valentinp72/star-track/cad/slew.gif

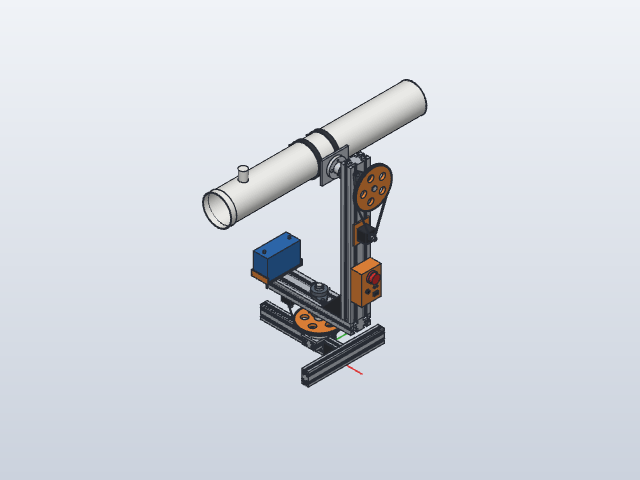
cad/slew.gif
