valentinp72/star-track/cad/electronics-box.stl

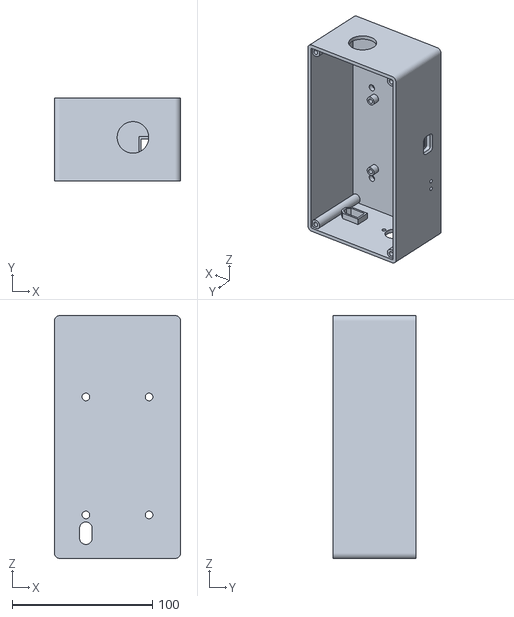
[picture p5: CAD file, 2026-11-12]
cad/electronics-box.stl
90.0 x 59.0 x 173.0
