valentinp72/star-track/cad/electronics-box-lid.stl

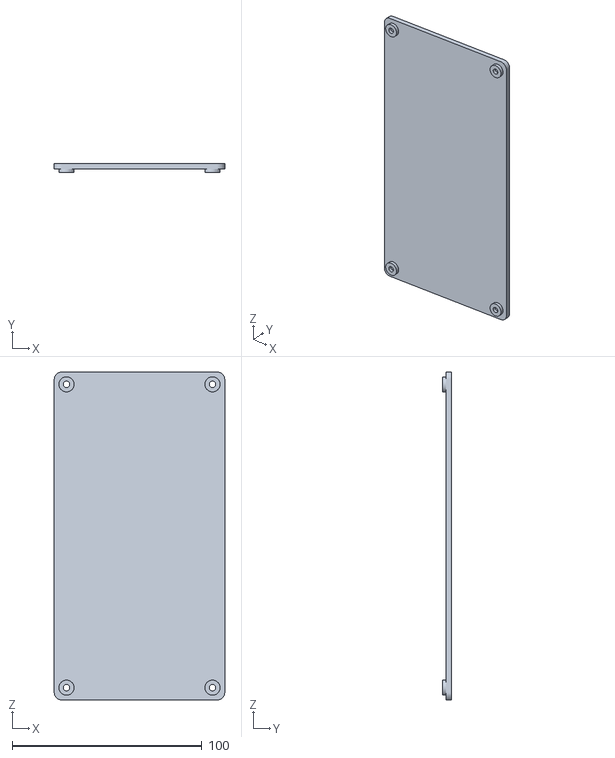
[picture p6: CAD file, 2026-11-12]
cad/electronics-box-lid.stl
90.0 x 5.00 x 173.0
