valentinp72/star-track/cad/knob-m5.stl

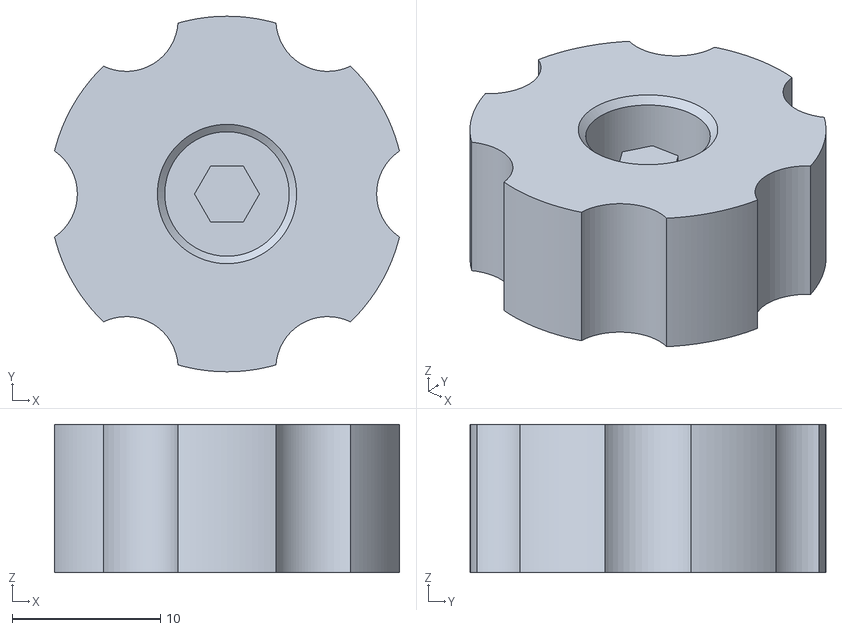
[picture p7: CAD file, 2026-11-04]
cad/knob-m5.stl
23.3 x 24.0 x 10.0
