valentinp72/star-track/cad/azimuth-motor-spacer.stl

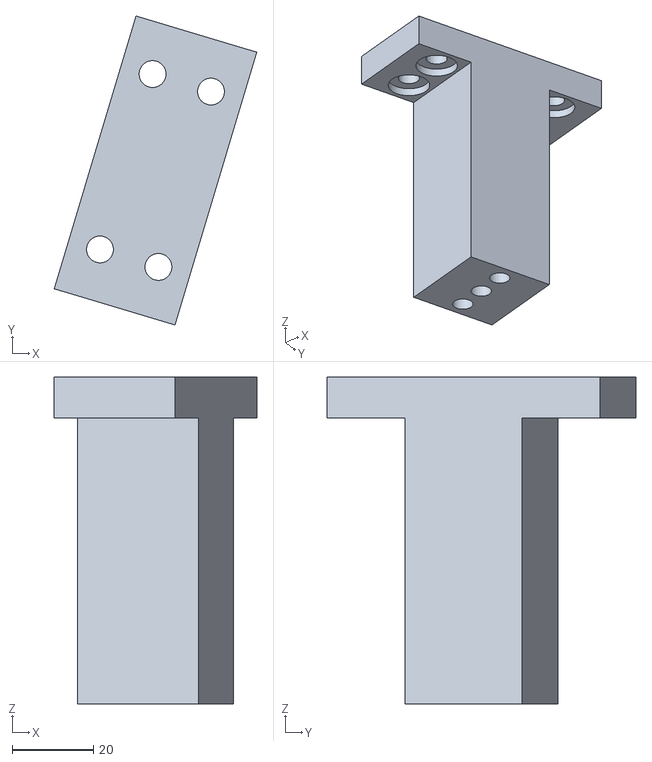
[picture p8: CAD file, 2026-11-04]
cad/azimuth-motor-spacer.stl
49.8 x 76.0 x 80.3
