valentinp72/star-track/cad/altitude-motor-spacer.stl

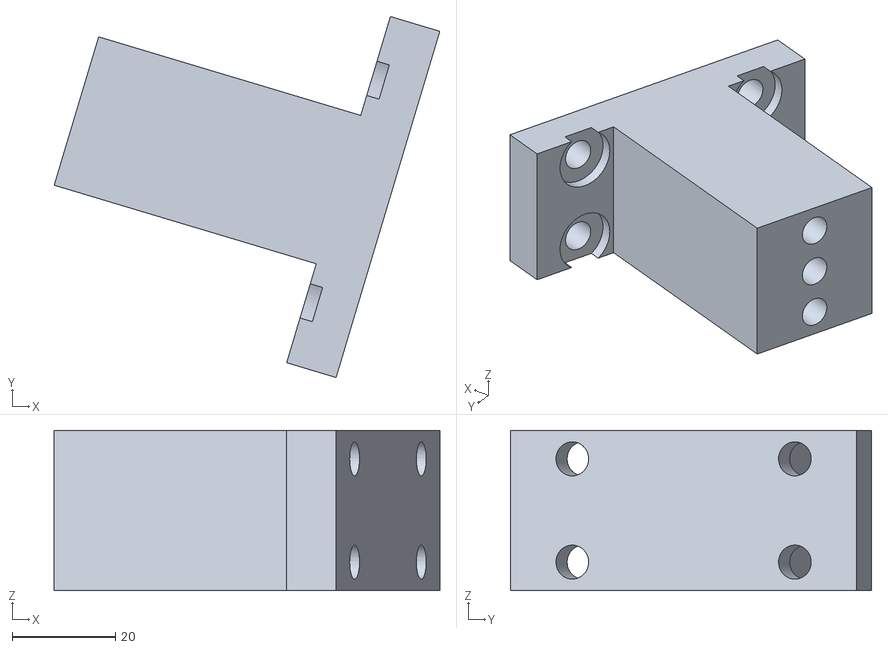
[picture p9: CAD file, 2026-11-04]
cad/altitude-motor-spacer.stl
74.7 x 69.9 x 31.0
