valentinp72/star-track/cad/pulley-gt2-250t.stl

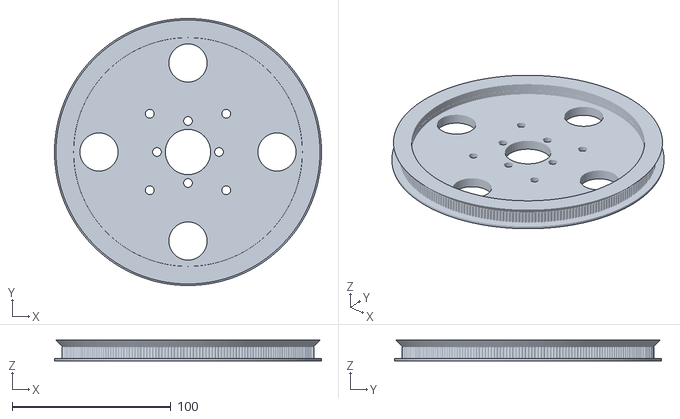
[picture p10: CAD file, 2026-10-29]
cad/pulley-gt2-250t.stl
168.0 x 168.0 x 13.0
