valentinp72/star-track/cad/azimuth-pulley-ring.stl

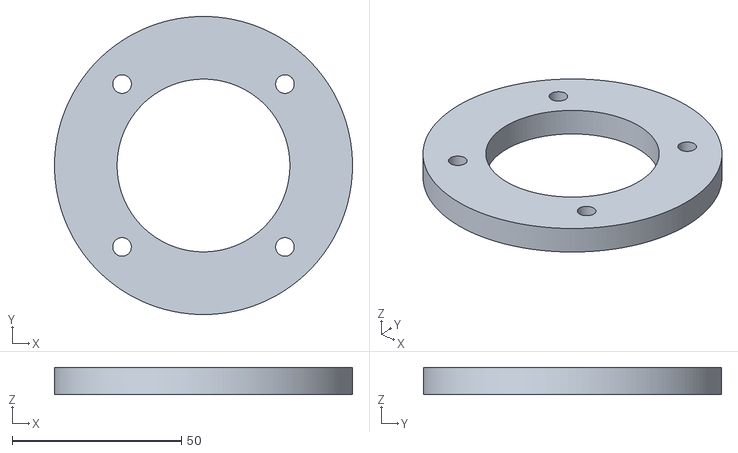
[picture p11: CAD file, 2026-10-29]
cad/azimuth-pulley-ring.stl
88.0 x 88.0 x 8.00
