valentinp72/star-track/electronics/star-track.pdf

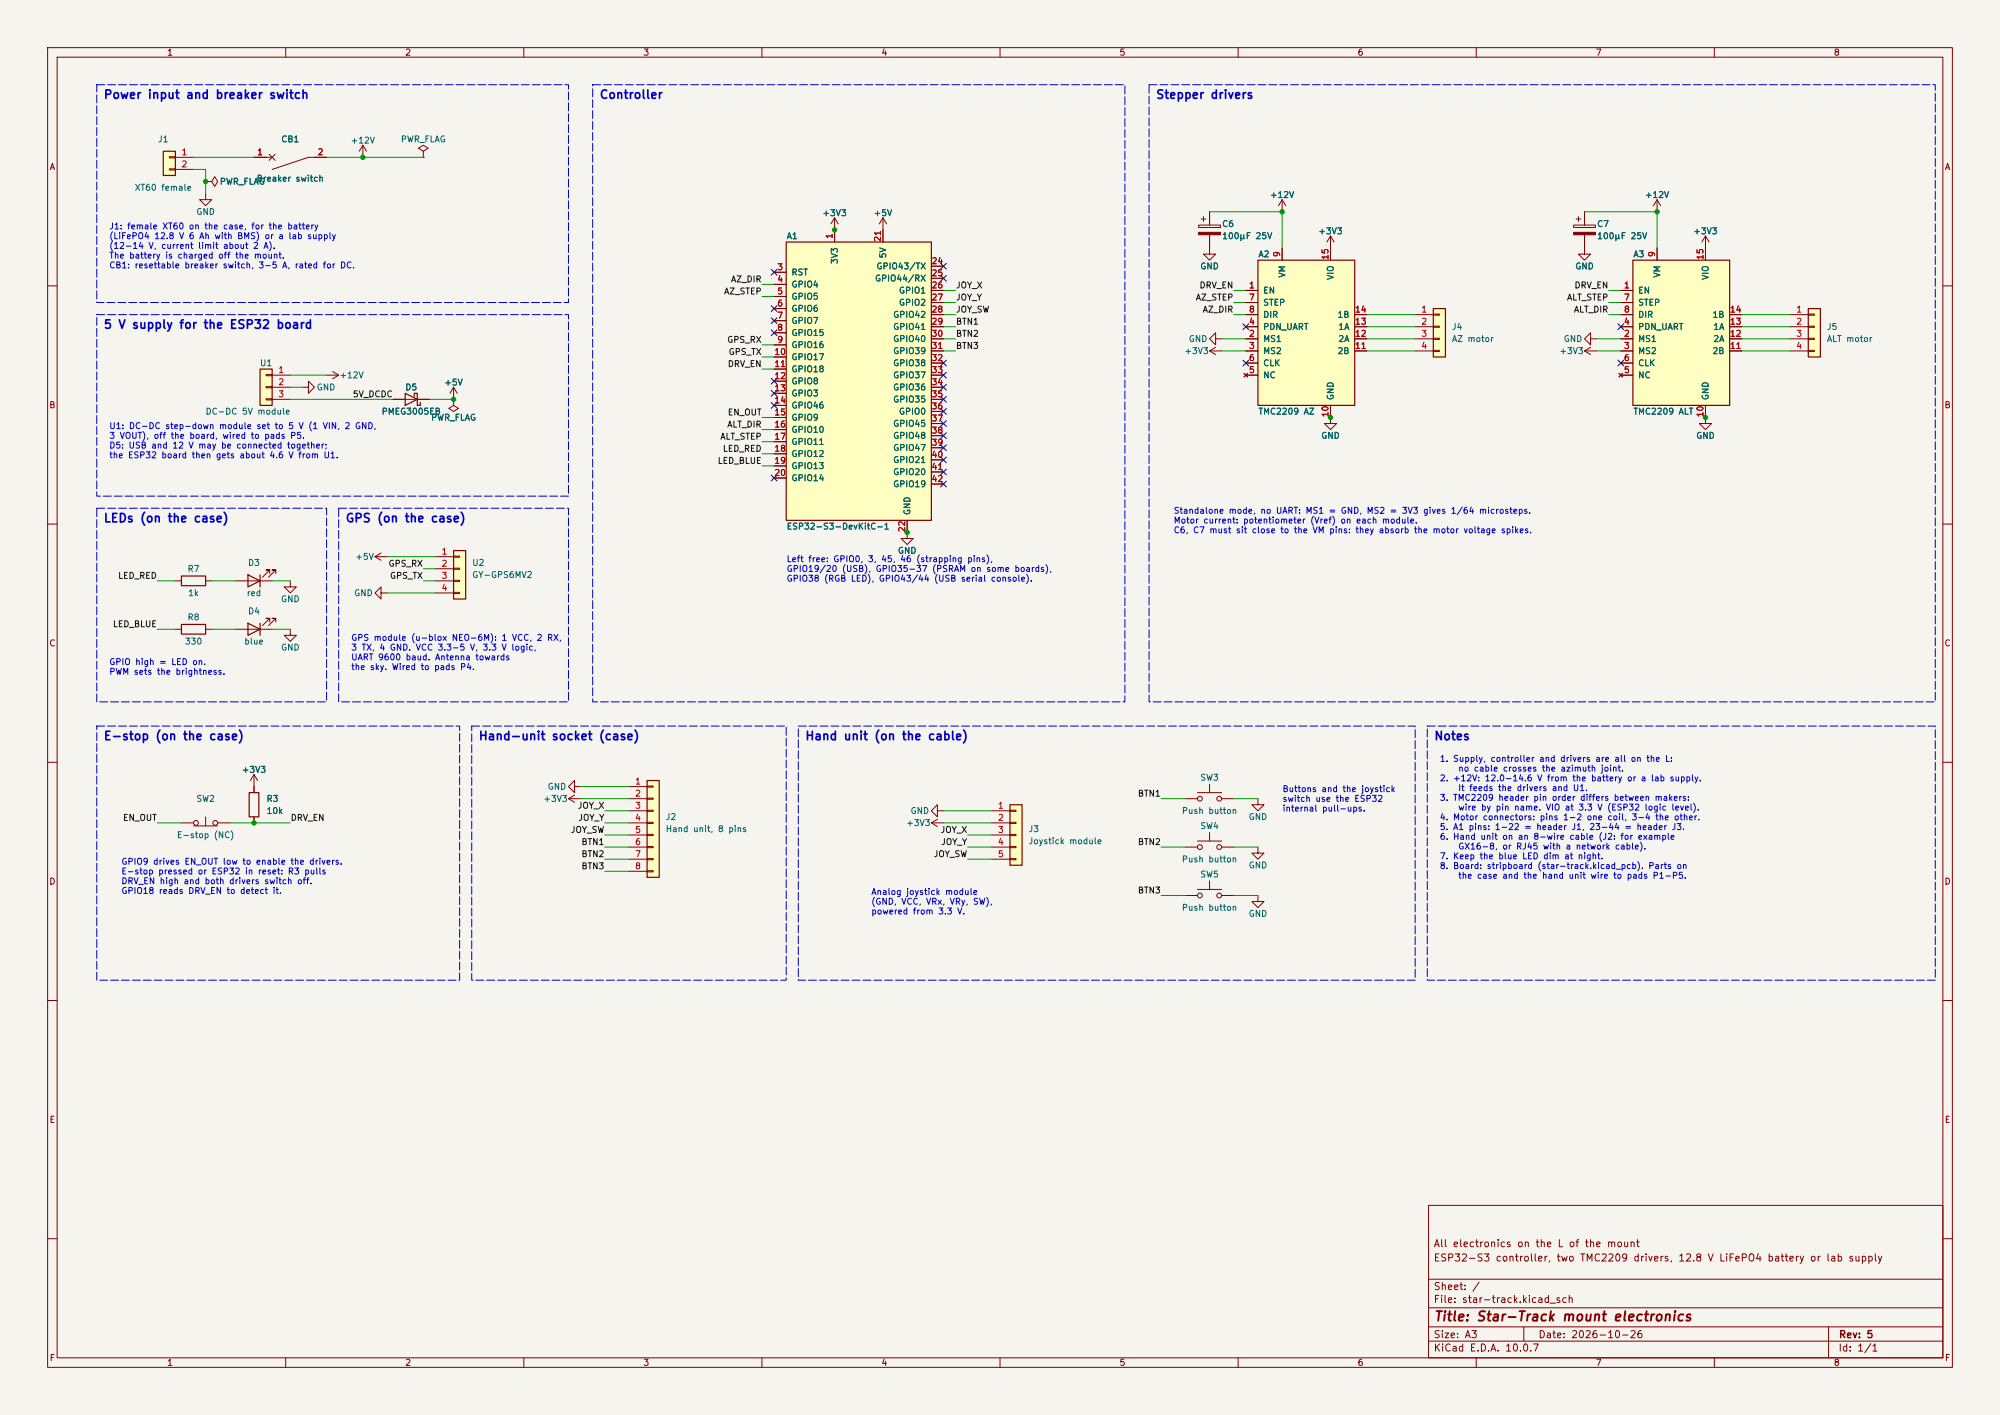
[picture p12: page 1]

Power input and breaker switch

J1: female XT60 on the case, for the battery
(LiFePO4 12.8 V 6 Ah with BMS) or a lab supply

5 V supply for the ESP32 board

powered from 3.3 V. LEDs (on the case) GPIO high = LED on. PWM sets the brightness.
EN_OUT LED_RED

the case and the hand unit wire to pads P1-P5. Standalone mode, no UART: MS1 = GND, MS2 = 3V3 gives 1/64 microsteps. Motor current: potentiometer (Vref) on each module. C6, C7 must sit close to the VM pins: they absorb the motor voltage spikes.

internal pull-ups. Left free: GPIO0, 3, 45, 46 (strapping pins),
GPIO19/20 (USB), GPIO35-37 (PSRAM on some boards), GPIO38 (RGB LED), GPIO43/44 (USB serial console).

Hand unit (on the cable)

It feeds the drivers and U1. 3. TMC2209 header pin order differs between makers: wire by pin name. VIO at 3.3 V (ESP32 logic level). 4. Motor connectors: pins 1-2 one coil, 3-4 the other. 5. A1 pins: 1-22 = header J1, 23-44 = header J3. 6. Hand unit on an 8-wire cable (J2: for example

GX16-8, or RJ45 with a network cable). 7. Keep the blue LED dim at night. 8. Board: stripboard (star-track.kicad_pcb). Parts on

Analog joystick module
(GND, VCC, VRx, VRy, SW),

All electronics on the L of the mount GND

ESP32-S3 controller, two TMC2209 drivers, 12.8 V LiFePO4 battery or lab supply

Sheet: /
File: star-track.kicad_sch
Title: Star-Track mount electronics

Size: A3 | Rev: 5 | F Date: 2026-10-26
KiCad E.D.A. 10.0.7 | Id: 1/1
