valentinp72/star-track/electronics/star-track.kicad_pcb

## KiCad design electronics/star-track.kicad_pcb (2026-11-09)

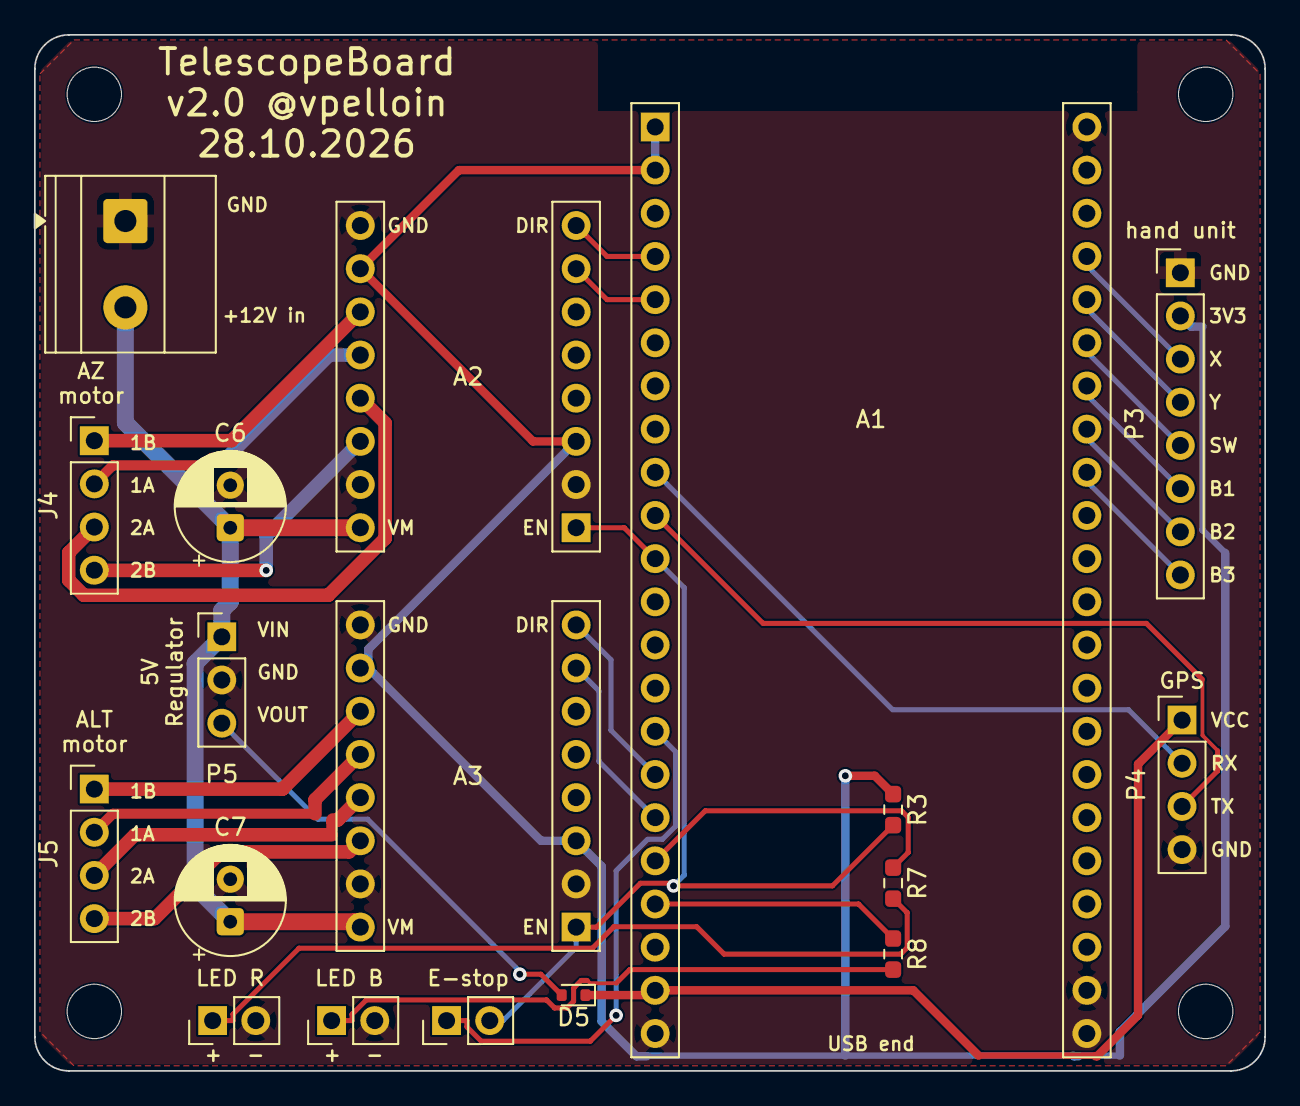
[picture p13: board star-track.kicad_pcb from above]

Board: 2 copper layers, 72.4 x 61.0 mm, 22 parts (0 on the bottom side), 31 nets.

Parts:
A1: ESP32-S3-DevKitC-1; ESP32-S3-DevKitC-1_Socket
A2: TMC2209 AZ; TMC2209_StepStick_Socket
A3: TMC2209 ALT; TMC2209_StepStick_Socket
C6, C7: 100µF 25V; CP_Radial_D6.3mm_P2.50mm
D5: PMEG3005EB; D_SOD-523
H1, H2, H3, H4: MountingHole_3.2mm_M3
J4: AZ motor; PinHeader_1x04_P2.54mm_Vertical
J5: ALT motor; PinHeader_1x04_P2.54mm_Vertical
P1: EK508V-02P; TerminalBlock_Phoenix_MKDS-1,5-2-5.08_1x02_P5.08mm_Horizont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
P2: Red LED (D3); PinHeader_1x02_P2.54mm_Vertical
P3: Hand unit (J2); PinHeader_1x08_P2.54mm_Vertical
P4: GPS (U2); PinHeader_1x04_P2.54mm_Vertical
P5: DC-DC 5V (U1); PinHeader_1x03_P2.54mm_Vertical
P6: Blue LED (D4); PinHeader_1x02_P2.54mm_Vertical
P7: E-stop (SW2); PinHeader_1x02_P2.54mm_Vertical
R3: 220; R_0603_1608Metric_Pad0.98x0.95mm_HandSolder
R7: 1k; R_0603_1608Metric_Pad0.98x0.95mm_HandSolder
R8: 330; R_0603_1608Metric_Pad0.98x0.95mm_HandSolder

Connections:
+3V3: A1.1, A1.2, A2.3, A2.15, A3.3, A3.15, P3.2, R3.1
+5V: A1.21, D5.1, P4.1
+12V: A2.9, A3.9, C6.1, C7.1, P1.2, P5.1
/5V_DCDC: D5.2, P5.3
/ALT_DIR: A1.16, A3.8
/ALT_STEP: A1.17, A3.7
/AZ_DIR: A1.4, A2.8
/AZ_STEP: A1.5, A2.7
/BTN1: A1.29, P3.6
/BTN2: A1.30, P3.7
/BTN3: A1.31, P3.8
/DRV_EN: A1.11, A2.1, A3.1, P7.2, R3.2
/EN_OUT: A1.15, P7.1
/GPS_RX: A1.9, P4.2
/GPS_TX: A1.10, P4.3
/JOY_SW: A1.28, P3.5
/JOY_X: A1.26, P3.3
/JOY_Y: A1.27, P3.4
/LED_BLUE: A1.19, R8.1
/LED_RED: A1.18, R7.1
GND: A1.22, A1.23, A1.43, A1.44, A2.2, A2.10, A2.16, A3.2, A3.10, A3.16, C6.2, C7.2, P1.1, P2.2, P3.1, P4.4, P5.2, P6.2
unnamed: A2.13, J4.2
unnamed: A2.14, J4.1
unnamed: A2.12, J4.3
unnamed: A2.11, J4.4
unnamed: A3.13, J5.2
unnamed: A3.14, J5.1
unnamed: A3.12, J5.3
unnamed: A3.11, J5.4
unnamed: P2.1, R7.2
unnamed: P6.1, R8.2
