valentinp72/star-track/(commit log)

2025-12-17 wifi AP esp32
2026-10-25 Restart project with design notes and a 3D model of the mount
    The previous main (ESP-IDF Wi-Fi access point example) is kept as branch v3.
    - README.md: project summary and the earlier branches.
    - docs/architecture.md: planned ESP32-S3 controller, phone web app,
    firmware structure, emergency stop wiring.
    - docs/mechanics.md: current build dimensions from the CAD export,
    bearing redesign with flange bearings, base stability, transport.
    - docs/3d/index.html: interactive 3D model of the redesigned mount.
    Claude-Session: https://claude.ai/code/session_019gYbrjmddARBSj5u2J2ySh
2026-10-25 Add battery power design and electronics schematic
    - electronics/: KiCad 7 schematic (with PDF and PNG exports) of the
    12.8 V LiFePO4 power path, L7805 5 V supply, battery voltage divider,
    ESP32-S3-DevKitC-1, two TMC2209 drivers on a shared UART, E-stop,
    joystick and buttons. Project symbol library for the board and the
    driver module.
    - docs/architecture.md: power, pin assignment, driver wiring, runtime
    estimate and placement on the L; azimuth needs no cable-wrap limit.
    - docs/mechanics.md: battery at the far end of the bar, smaller
    electronics case without screen, updated transport size.
    - docs/3d: battery in a printed cradle, battery cable, new case with
    E-stop, joystick and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
2026-10-25 Drop charging circuit; add hand unit, LEDs and buzzer
    - Schematic: female XT60 input for the battery or a lab supply, no
    charge socket. Joystick and buttons moved to a hand unit on an 8-pin
    socket, with 100 nF filters on the joystick lines. Red and blue LEDs
    (GPIO15, GPIO16) and a buzzer driven by an NPN transistor (GPIO21).
    - docs/architecture.md: hand unit, feedback, power input and lab supply,
    notes on charging LiFePO4 with a lead-acid charger.
    - docs/mechanics.md, docs/3d: case face with E-stop, LEDs, buzzer and
    main switch, sockets underneath; packed head size updated.
    Claude-Session: https://claude.ai/code/session_019gY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
2026-10-25 Simplify the circuit to the parts that are needed
    - Resettable breaker switch replaces the fuse and the main switch.
    - TMC2209 drivers in standalone mode (1/64 microsteps with MS1/MS2,
    current from the Vref potentiometer): no UART resistor or wires.
    - Buzzer directly on GPIO21, without the transistor stage.
    - Removed the bulk and regulator capacitors, the battery voltage
    divider and the joystick filter capacitors.
    - docs/architecture.md: why the remaining parts are needed, and a
    "Left out" table with what each removed part would add.
    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
2026-10-25 Remove the diode between the L7805 and the ESP32 board
    The L7805 output goes straight to the board's 5V pin. Espressif lists
    the board's USB ports and 5V pin as mutually exclusive power inputs,
    so the docs and schematic now say not to connect USB while the breaker
    is on, and to use Wi-Fi for logs and updates when the mount is powered.
    The diode is listed under "Left out" for USB debugging with the motors
    powered.
    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
2026-10-25 SolidCraft assembly
2026-10-25 Mount the tube with the original clasp on a plate on the altitude coupling
    Replace the Vixen dovetail with the Omegon tube clasp, fixed to a
    100 x 121 x 8 aluminium plate bolted directly to the altitude flange
    coupling. The coupling is turned 45 degrees and two of its holes are
    drilled out to 10.5 mm so the clasp bolts (60 mm apart) pass through it.
    Raise the altitude axis by 50 mm (now 70 mm below the top of the arm),
    with the altitude motor, bracket and belt, so the back of the tube
    clears the top of the azimuth shaft near the zenith. The tube can slide
    -60 / +40 mm in the clasp for balancing.
    Ignore SolidCraft lock and backup files.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
2026-10-26 Add a stripboard layout for the electronics, and a parts list
    - electronics/star-track.kicad_pcb: 24 x 56 hole stripboard. Strips are
    B.Cu tracks with 54 cuts, wire links are board-only parts with joined
    pads, so DRC checks the board against the schematic (0 violations).
    - Project footprints for the ESP32-S3-DevKitC-1 and the TMC2209 module.
    - Pictures of the component side and the copper side.
    - Schematic rev 5: GPIOs chosen to suit the stripboard, motor connector
    pins in module order, footprints assigned, case and hand-unit parts
    marked off the board.
    - docs: stripboard section, new pin table, electronics parts list.
    - Ignore KiCad local settings, locks and backups.
    Co-Authored-By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
2026-10-26 Drop the buzzer; colour the stripboard pictures by net
    - Remove BZ1 and its GPIO from the schematic, the stripboard and the
    docs. Feedback at the mount is the two LEDs. P2 keeps five pads.
    - Stripboard pictures: one colour per net for the strips and the wire
    links, fixed colours for GND, +12V, +3V3 and +5V.
2026-10-27 Replace the L7805 with a DC-DC converter, add a GPS module
    - U1 is now a DC-DC step-down module set to 5 V, off the board on three
    wires (pads P5). The L7805 and its heatsink are gone.
    - GPS module GY-GPS6MV2 (u-blox NEO-6M) on GPIO16/17, powered from 5 V,
    wired to pads P4. It gives the time and the site to the firmware.
    - Motor cables are soldered into J4, J5.
    - Stripboard pictures: the notes under the board are laid out in columns.
    - docs: power, GPS, pins, power budget and parts list updated.
2026-10-27 Add a two-layer PCB for the electronics; move the stripboard to a subfolder
    - electronics/star-track.kicad_pcb: 72 x 61 mm, two layers, through-hole
    parts only, rounded corners, four M3 holes. Laid out by function:
    motor wires and power on the left edge, drivers in the middle, the
    ESP32 board on the right with the resistors under it, hand unit and
    GPS on the right edge, LEDs and E-stop on the bottom edge (each LED
    with its own GND pad). Power input on a 5.08 mm screw terminal.
    - Routed with Freerouting, GND fill on both layers except under the
    ESP32 antenna. DRC passes with no unconnected pads.
    - Gerber and drill files for ordering, and renders of both sides.
    - Net classes for th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
2026-10-28 Add a Schottky diode on the 5 V supply, use SMD resistors, re-route the PCB
    - D5 (PMEG3005EB) between the DC-DC output and the ESP32 board's 5V pin, so
    USB and the 12 V supply can be connected at the same time.
    - R3, R7, R8 as 0603 and D5 as SOD-523, for hand soldering; R8 now 330 ohm.
    - PCB: C6 moved next to the azimuth driver's VM pin, new placement and
    routing, antenna keep-out with no copper, orientation labels on the driver
    sockets and the ESP32 board, silkscreen strokes of at least 0.15 mm.
    - Gerbers, renders and docs updated.
2026-10-29 Match the model to the measured parts; set the drives for 610 mm belts
    - Base: 650 mm 30x60 crossbar (stem stays 350 mm), 60 mm angle brackets,
    four 30x30 blocks of about 30 mm under the azimuth plate, three
    levelling feet (Ø40 pad, M8 x 80 rod) that raise everything by 50 mm.
    - L: 85 mm corner bracket, 90 mm wide.
    - Drives: with a 250-tooth pulley, a 20-tooth motor pulley and a 610 mm
    closed GT2 belt, both motors sit 152.4 mm from their axis. Belts redrawn.
    - mechanics.md: measured parts, slot sizes, tube clasp instead of the
    dovetail, new stability margins (about 11 cm toward the crossbar,
    15.5 cm to each side), transport sizes, printed parts sized for a
    180 mm bed, parts list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
2026-10-29 Add the printed 250-tooth pulley; mount the motors on aluminium plates
    - cad/pulley-gt2-250t.solidcraft and .stl: GT2 2 mm, 250 teeth, 7 mm belt
    section, Ø168 over the flanges (fits a 180 mm bed), printable without
    supports. Three bodies overlapping by 0.1 mm, fused by the slicer. Bore and
    bolt circle match the 20 mm flange coupling in the model.
    - Azimuth: the pulley lies on the base coupling's flange, held by the four
    thumb screws (now M6 x 25); the printed hub is gone.
    - Altitude: a second flange coupling on the outer end of the shaft carries
    the pulley; coupling, pulley and motor moved 6 mm out to clear the outer
    bearing's insert.
    - Both motors bolted to Motedis NEMA 17 plat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
2026-10-29 Replace the flange couplings with STHRB20 shaft holders and 200 mm rods
    - Three round-flange shaft holders STHRB20 (Ø50 x 8 flange, Ø28 hub, 32 long,
    4 x Ø5.5 on Ø39, set screws) replace the 20 mm flange couplings: azimuth
    base, altitude pulley side, tube side.
    - Azimuth: the pulley rests on the holder's flange over a printed 8 mm ring;
    four M5 x 20 thumb screws on Ø68 go through the pulley and the ring into the
    base plate, clamping the holder. Motor, plate and belt 4 mm lower; spacer
    80 mm tall.
    - Altitude: pulley bolted to the holder with 4 x M5; the clasp plate gets
    4 M5 tapped holes for the tube-side holder instead of the drilled coupling.
    - Pulley centre: Ø28.5 bore, 4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
2026-11-04 Replace the thumb screws with printed knobs; use M6 screws on the spacers
    - Printed knob (cad/knob-m5) pressed onto an M5 x 20 socket head screw,
    with a hex key into the screw's socket, replaces the DIN 464 thumb
    screws on the azimuth pulley.
    - Motor spacers: Ø6.6 holes with Ø13 x 2.5 counterbores for M6 x 20
    screws, washers and slot-10 T-nuts instead of M8 bolts.
    - Altitude pulley on M5 x 20 screws and nuts; holder to clasp plate on
    M5 x 20 cut to 16; M3 x 8 for the motors.
    - Parts lists and 3D page updated.
2026-11-09 Add a board test sketch; use a 220 Ω pull-up on the drivers' EN line
    - firmware/board-test: Arduino sketch (arduino-cli, ESP32 Arduino core 3.x)
    with a serial menu to check the soldered board: LEDs, E-stop, GPS,
    motors, hand unit, and a live E-stop view on the LEDs.
    - R3 from 10 kΩ to 220 Ω: the TMC2209 modules pull EN to GND (about 8 kΩ
    for both), so a pressed E-stop only reached 1.6 V. With 220 Ω, 2.8 V
    pressed and 0.6-0.7 V released (measured). GPIO9 uses the strongest
    drive to sink the current.
    - Firmware built with arduino-cli instead of PlatformIO.
    - On USB alone the ESP32 board gives no 5 V on its 5V pin, so the GPS
    needs the 12 V supply (measured).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
2026-11-12 Add the printed electronics box for the arm
    90 × 173 × 62 box on the outer face of the 45×90 arm, held by four M5
    screws in its slots. It holds the main PCB and the GPS on M3 heat-set
    inserts. The E-stop is on top, with a press-fit clip for the GPS antenna
    under the top wall. The USB port and the LEDs go through a side wall.
    The XT60 and GX16-8 sockets are underneath, and the motor cables leave
    through the back into an arm slot. The lid is held by four counterbored
    M3 screws.
2026-11-12 Refine the electronics box and add part mock-ups
    - Make the box 59 deep so the E-stop's Ø60 legend plate fits on the flat of
    the top face, and move the E-stop off the corner rounding.
    - Replace the USB opening with a recess for the main USB-C port only:
    a rounded, chamfered pocket for the plug's moulding and a small hole for
    its shell, placed from measurements.
    - Use counterbored M3 screws for the lid.
    - Shape the XT60 hole after the Amass XT60-F outline (chamfers on one short
    end) and add a lip around it inside.
    - Add mock-up bodies (PCB, GPS and antenna, E-stop, XT60, GX16-8) to check
    the fit; they are not in the STLs.
